fallenpegasus/bliplace/Bliplace instructions.pages/QuickLook/Thumbnail.jpg

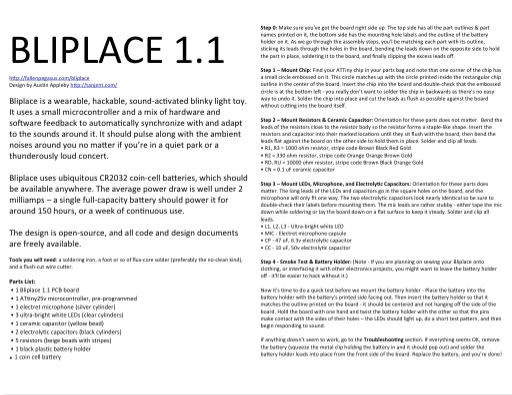
Bliplace instructions.pages/QuickLook/Thumbnail.jpg
